kimaernoudt/custom-ahm-wallpanel/3d/render-back.png

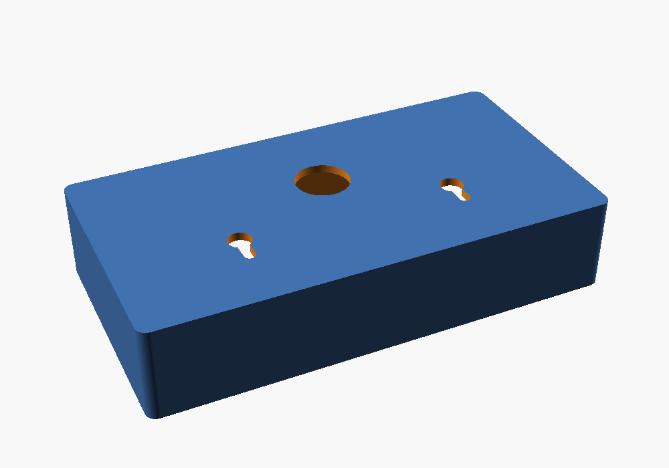
3d/render-back.png
