kimaernoudt/custom-ahm-wallpanel/pcb/parts.csv

ref | value | footprint | lcsc | side
ENC1 | EC11E with switch, 20 mm shaft | RotaryEncoder_Alps_EC11E-Switch_Vertical_H20mm |  | top
ENC2 | EC11E with switch, 20 mm shaft | RotaryEncoder_Alps_EC11E-Switch_Vertical_H20mm |  | top
ENC3 | EC11E with switch, 20 mm shaft | RotaryEncoder_Alps_EC11E-Switch_Vertical_H20mm |  | top
ENC4 | EC11E with switch, 20 mm shaft | RotaryEncoder_Alps_EC11E-Switch_Vertical_H20mm |  | top
LED1 | WS2812B-B | LED_WS2812B_PLCC4_5.0x5.0mm_P3.2mm |  | top
LED2 | WS2812B-B | LED_WS2812B_PLCC4_5.0x5.0mm_P3.2mm |  | top
LED3 | WS2812B-B | LED_WS2812B_PLCC4_5.0x5.0mm_P3.2mm |  | top
LED4 | WS2812B-B | LED_WS2812B_PLCC4_5.0x5.0mm_P3.2mm |  | top
LED5 | WS2812B-B | LED_WS2812B_PLCC4_5.0x5.0mm_P3.2mm |  | top
LED6 | WS2812B-B | LED_WS2812B_PLCC4_5.0x5.0mm_P3.2mm |  | top
LED7 | WS2812B-B | LED_WS2812B_PLCC4_5.0x5.0mm_P3.2mm |  | top
LED8 | WS2812B-B | LED_WS2812B_PLCC4_5.0x5.0mm_P3.2mm |  | top
LED9 | WS2812B-B | LED_WS2812B_PLCC4_5.0x5.0mm_P3.2mm |  | top
LED10 | WS2812B-B | LED_WS2812B_PLCC4_5.0x5.0mm_P3.2mm |  | top
LED11 | WS2812B-B | LED_WS2812B_PLCC4_5.0x5.0mm_P3.2mm |  | top
LED12 | WS2812B-B | LED_WS2812B_PLCC4_5.0x5.0mm_P3.2mm |  | top
LED13 | WS2812B-B | LED_WS2812B_PLCC4_5.0x5.0mm_P3.2mm |  | top
LED14 | WS2812B-B | LED_WS2812B_PLCC4_5.0x5.0mm_P3.2mm |  | top
LED15 | WS2812B-B | LED_WS2812B_PLCC4_5.0x5.0mm_P3.2mm |  | top
LED16 | WS2812B-B | LED_WS2812B_PLCC4_5.0x5.0mm_P3.2mm |  | top
LED17 | WS2812B-B | LED_WS2812B_PLCC4_5.0x5.0mm_P3.2mm |  | top
LED18 | WS2812B-B | LED_WS2812B_PLCC4_5.0x5.0mm_P3.2mm |  | top
LED19 | WS2812B-B | LED_WS2812B_PLCC4_5.0x5.0mm_P3.2mm |  | top
LED20 | WS2812B-B | LED_WS2812B_PLCC4_5.0x5.0mm_P3.2mm |  | top
LED21 | WS2812B-B | LED_WS2812B_PLCC4_5.0x5.0mm_P3.2mm |  | top
LED22 | WS2812B-B | LED_WS2812B_PLCC4_5.0x5.0mm_P3.2mm |  | top
LED23 | WS2812B-B | LED_WS2812B_PLCC4_5.0x5.0mm_P3.2mm |  | top
LED24 | WS2812B-B | LED_WS2812B_PLCC4_5.0x5.0mm_P3.2mm |  | top
LED25 | WS2812B-B | LED_WS2812B_PLCC4_5.0x5.0mm_P3.2mm |  | top
LED26 | WS2812B-B | LED_WS2812B_PLCC4_5.0x5.0mm_P3.2mm |  | top
LED27 | WS2812B-B | LED_WS2812B_PLCC4_5.0x5.0mm_P3.2mm |  | top
LED28 | WS2812B-B | LED_WS2812B_PLCC4_5.0x5.0mm_P3.2mm |  | top
LED29 | WS2812B-B | LED_WS2812B_PLCC4_5.0x5.0mm_P3.2mm |  | top
LED30 | WS2812B-B | LED_WS2812B_PLCC4_5.0x5.0mm_P3.2mm |  | top
LED31 | WS2812B-B | LED_WS2812B_PLCC4_5.0x5.0mm_P3.2mm |  | top
LED32 | WS2812B-B | LED_WS2812B_PLCC4_5.0x5.0mm_P3.2mm |  | top
LED33 | WS2812B-B | LED_WS2812B_PLCC4_5.0x5.0mm_P3.2mm |  | top
LED34 | WS2812B-B | LED_WS2812B_PLCC4_5.0x5.0mm_P3.2mm |  | top
LED35 | WS2812B-B | LED_WS2812B_PLCC4_5.0x5.0mm_P3.2mm |  | top
LED36 | WS2812B-B | LED_WS2812B_PLCC4_5.0x5.0mm_P3.2mm |  | top
LED37 | WS2812B-B | LED_WS2812B_PLCC4_5.0x5.0mm_P3.2mm |  | top
LED38 | WS2812B-B | LED_WS2812B_PLCC4_5.0x5.0mm_P3.2mm |  | top
LED39 | WS2812B-B | LED_WS2812B_PLCC4_5.0x5.0mm_P3.2mm |  | top
LED40 | WS2812B-B | LED_WS2812B_PLCC4_5.0x5.0mm_P3.2mm |  | top
LED41 | WS2812B-B | LED_WS2812B_PLCC4_5.0x5.0mm_P3.2mm |  | top
LED42 | WS2812B-B | LED_WS2812B_PLCC4_5.0x5.0mm_P3.2mm |  | top
LED43 | WS2812B-B | LED_WS2812B_PLCC4_5.0x5.0mm_P3.2mm |  | top
LED44 | WS2812B-B | LED_WS2812B_PLCC4_5.0x5.0mm_P3.2mm |  | top
LED45 | WS2812B-B | LED_WS2812B_PLCC4_5.0x5.0mm_P3.2mm |  | top
LED46 | WS2812B-B | LED_WS2812B_PLCC4_5.0x5.0mm_P3.2mm |  | top
LED47 | WS2812B-B | LED_WS2812B_PLCC4_5.0x5.0mm_P3.2mm |  | top
LED48 | WS2812B-B | LED_WS2812B_PLCC4_5.0x5.0mm_P3.2mm |  | top
LED49 | WS2812B-B | LED_WS2812B_PLCC4_5.0x5.0mm_P3.2mm |  | top
LED50 | WS2812B-B | LED_WS2812B_PLCC4_5.0x5.0mm_P3.2mm |  | top
LED51 | WS2812B-B | LED_WS2812B_PLCC4_5.0x5.0mm_P3.2mm |  | top
LED52 | WS2812B-B | LED_WS2812B_PLCC4_5.0x5.0mm_P3.2mm |  | top
SW1 | 6x6 mm tact, 5 mm high | SW_PUSH_6mm_H5mm |  | top
SW2 | 6x6 mm tact, 5 mm high | SW_PUSH_6mm_H5mm |  | top
R2 | 3.3k | R_0805_2012Metric |  | top
SW3 | 6x6 mm tact, 5 mm high | SW_PUSH_6mm_H5mm |  | top
R3 | 8.2k | R_0805_2012Metric |  | top
SW4 | 6x6 mm tact, 5 mm high | SW_PUSH_6mm_H5mm |  | top
R4 | 22k | R_0805_2012Metric |  | top
C1 | 100nF | C_0805_2012Metric |  | top
U1 | MCP23017-E/SO | SOIC-28W_7.5x17.9mm_P1.27mm | C47023 | top
C2 | 100nF | C_0805_2012Metric |  | top
R5 | 10k | R_0805_2012Metric |  | top
J1 | UEXT 2x5 box header | IDC-Header_2x05_P2.54mm_Vertical |  | bottom
J2 | JST XH 2-pin | JST_XH_B2B-XH-A_1x02_P2.50mm_Vertical |  | bottom
C3 | 22uF | C_1206_3216Metric |  | top
C4 | 22uF | C_1206_3216Metric |  | top
C5 | 10uF | C_0805_2012Metric |  | top
C6 | 10uF | C_0805_2012Metric |  | top
C7 | 10uF | C_0805_2012Metric |  | top
C8 | 10uF | C_0805_2012Metric |  | top
U2 | 74AHCT1G125 | SOT-23-5 | C7484 | top
C9 | 100nF | C_0805_2012Metric |  | top
R8 | 33R | R_0805_2012Metric |  | top
