kimaernoudt/custom-ahm-wallpanel/3d/faceplate-pcb.stl

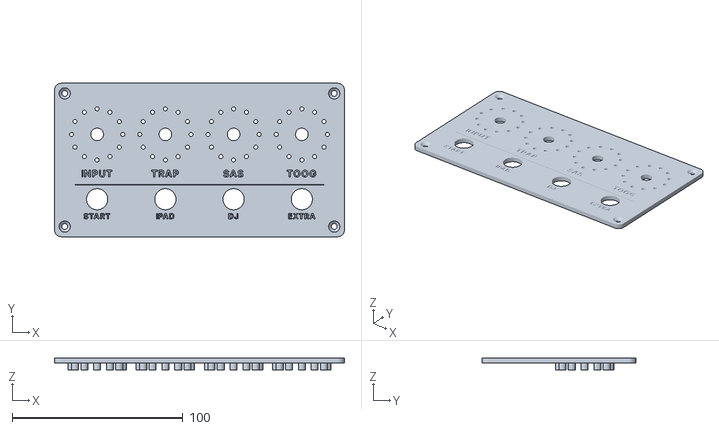
[picture p6: CAD file, 2026-10-20]
3d/faceplate-pcb.stl
170.0 x 90.0 x 7.30
