kimaernoudt/custom-ahm-wallpanel/3d/buttoncap.stl

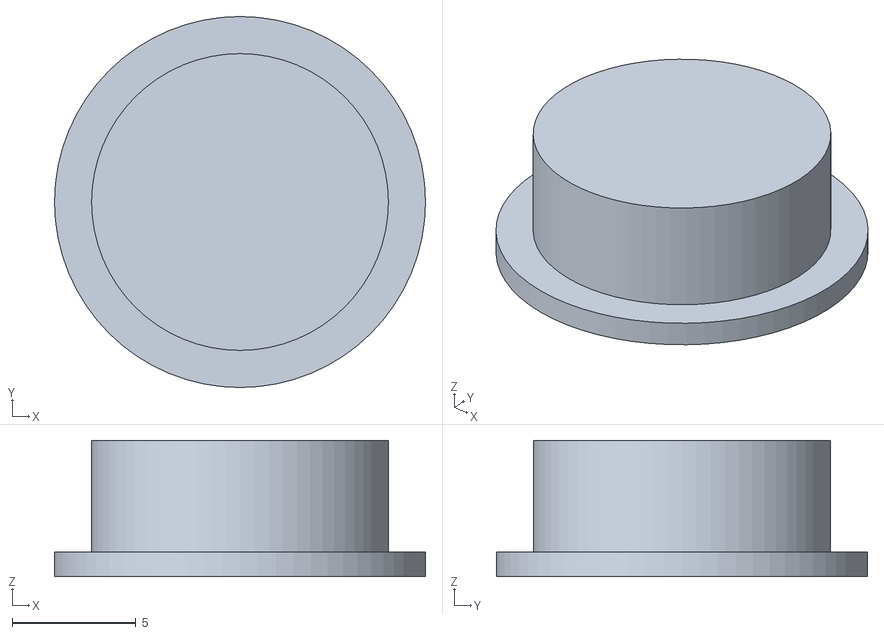
[picture p7: CAD file, 2026-10-20]
3d/buttoncap.stl
15.0 x 15.0 x 5.50
