kimaernoudt/custom-ahm-wallpanel/3d/backbox.stl

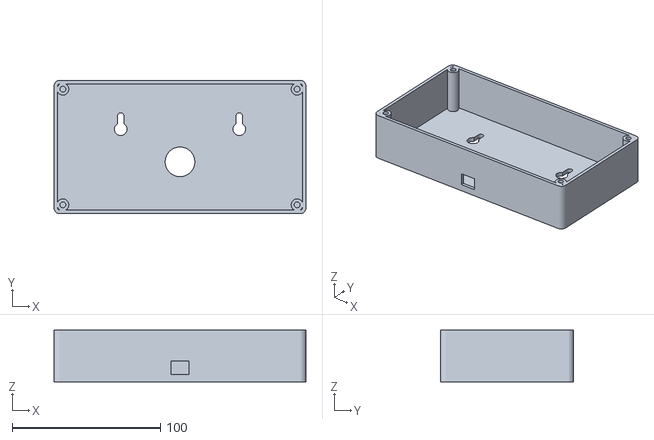
[picture p8: CAD file, 2026-10-19]
3d/backbox.stl
170.0 x 90.0 x 35.0
