kimaernoudt/custom-ahm-wallpanel/3d/faceplate.stl

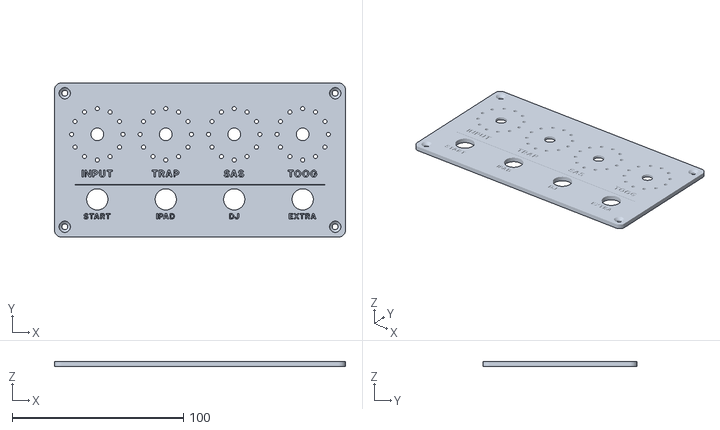
[picture p9: CAD file, 2026-10-19]
3d/faceplate.stl
170.0 x 90.0 x 3.00
