kimaernoudt/custom-ahm-wallpanel/3d/labels.stl

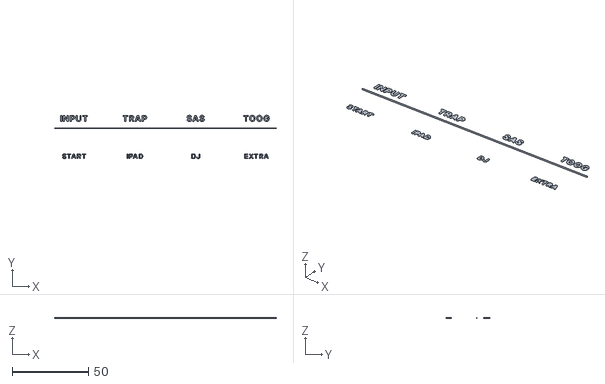
[picture p10: CAD file, 2026-10-19]
3d/labels.stl
146.0 x 28.6 x 0.6
