kimaernoudt/custom-ahm-wallpanel/3d/render-assembly.png

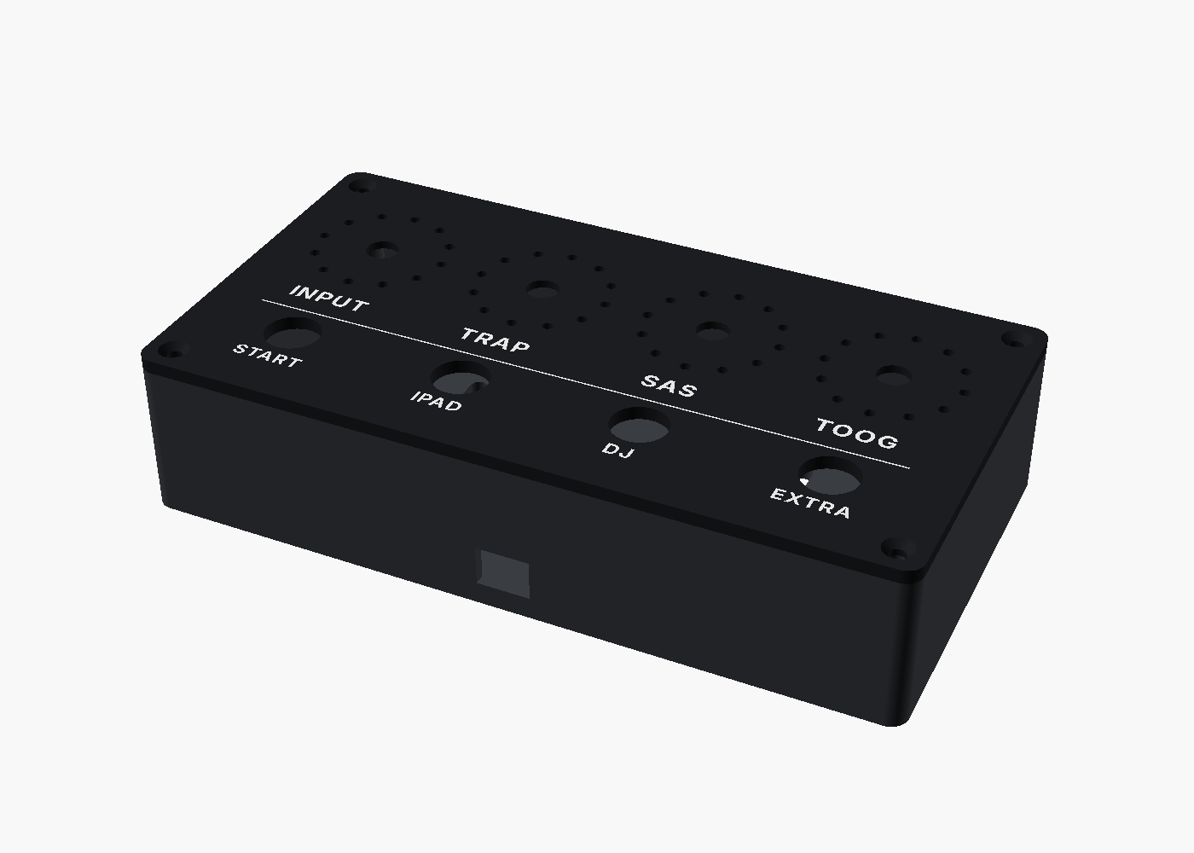
3d/render-assembly.png
