kimaernoudt/custom-ahm-wallpanel/pcb/ahm-panel.kicad_pcb

## KiCad design pcb/ahm-panel.kicad_pcb (2026-10-21)

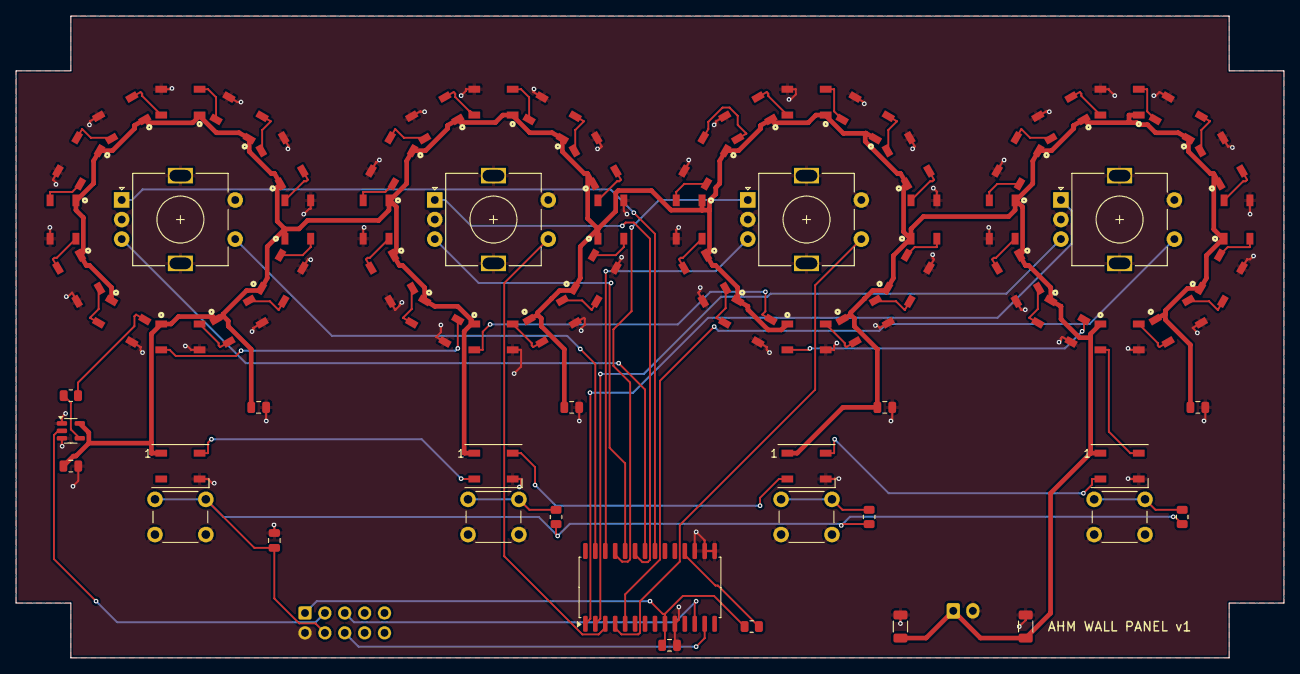
[picture p12: board ahm-panel.kicad_pcb from above]

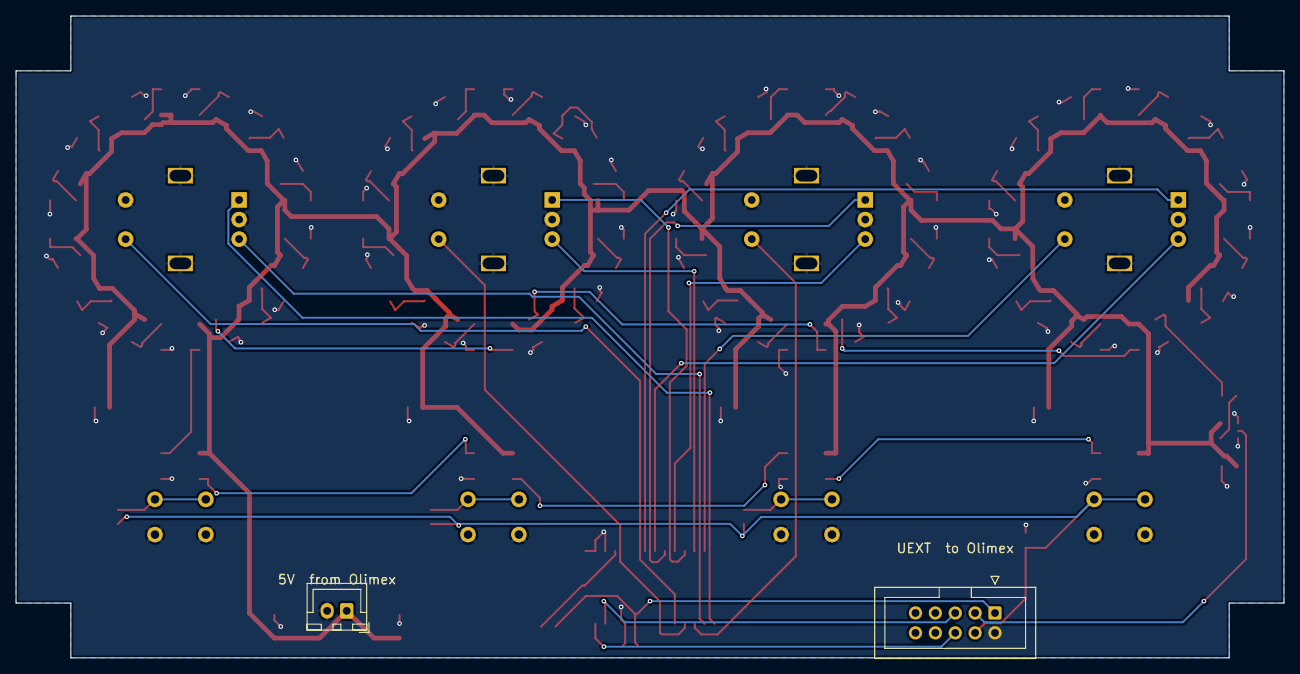
[picture p13: board ahm-panel.kicad_pcb from below]

Board: 2 copper layers, 162.0 x 82.0 mm, 78 parts (2 on the bottom side), 76 nets.

Parts:
C1, C2, C9: 100nF; C_0805_2012Metric
C3, C4: 22uF; C_1206_3216Metric
C5, C6, C7, C8: 10uF; C_0805_2012Metric
ENC1, ENC2, ENC3, ENC4: EC11E with switch, 20 mm shaft; RotaryEncoder_Alps_EC11E-Switch_Vertical_H20mm
J1: UEXT 2x5 box header; IDC-Header_2x05_P2.54mm_Vertical
J2: JST XH 2-pin; JST_XH_B2B-XH-A_1x02_P2.50mm_Vertical
LED1, LED2, LED3, LED4, LED5, LED6, LED7, LED8, LED9, LED10, LED11, LED12, LED13, LED14, LED15, LED16, LED17, LED18, LED19, LED20, LED21, LED22, LED23, LED24, LED25, LED26, LED27, LED28, LED29, LED30, LED31, LED32, LED33, LED34, LED35, LED36, LED37, LED38, LED39, LED40, LED41, LED42, LED43, LED44, LED45, LED46, LED47, LED48, LED49, LED50, LED51, LED52: WS2812B-B; LED_WS2812B_PLCC4_5.0x5.0mm_P3.2mm
R2: 3.3k; R_0805_2012Metric
R3: 8.2k; R_0805_2012Metric
R4: 22k; R_0805_2012Metric
R5: 10k; R_0805_2012Metric
R8: 33R; R_0805_2012Metric
SW1, SW2, SW3, SW4: 6x6 mm tact, 5 mm high; SW_PUSH_6mm_H5mm
U1: MCP23017-E/SO; SOIC-28W_7.5x17.9mm_P1.27mm
U2: 74AHCT1G125; SOT-23-5

Connections:
+3V3: C2.1, J1.1, R5.1, U1.9
+5V: C3.1, C4.1, C5.1, C6.1, C7.1, C8.1, C9.1, J2.1, LED1.1, LED2.1, LED3.1, LED4.1, LED5.1, LED6.1, LED7.1, LED8.1, LED9.1, LED10.1, LED11.1, LED12.1, LED13.1, LED14.1, LED15.1, LED16.1, LED17.1, LED18.1, LED19.1, LED20.1, LED21.1, LED22.1, LED23.1, LED24.1, LED25.1, LED26.1, LED27.1, LED28.1, LED29.1, LED30.1, LED31.1, LED32.1, LED33.1, LED34.1, LED35.1, LED36.1, LED37.1, LED38.1, LED39.1, LED40.1, LED41.1, LED42.1, LED43.1, LED44.1, LED45.1, LED46.1, LED47.1, LED48.1, LED49.1, LED50.1, LED51.1, LED52.1, U2.5
D1: LED1.2, LED2.4
D2: LED2.2, LED3.4
D3: LED3.2, LED4.4
D4: LED4.2, LED5.4
D5: LED5.2, LED6.4
D6: LED6.2, LED7.4
D7: LED7.2, LED8.4
D8: LED8.2, LED9.4
D9: LED9.2, LED10.4
D10: LED10.2, LED11.4
D11: LED11.2, LED12.4
D12: LED12.2, LED13.4
D13: LED13.2, LED14.4
D14: LED14.2, LED15.4
D15: LED15.2, LED16.4
D16: LED16.2, LED17.4
D17: LED17.2, LED18.4
D18: LED18.2, LED19.4
D19: LED19.2, LED20.4
D20: LED20.2, LED21.4
D21: LED21.2, LED22.4
D22: LED22.2, LED23.4
D23: LED23.2, LED24.4
D24: LED24.2, LED25.4
D25: LED25.2, LED26.4
D26: LED26.2, LED27.4
D27: LED27.2, LED28.4
D28: LED28.2, LED29.4
D29: LED29.2, LED30.4
D30: LED30.2, LED31.4
D31: LED31.2, LED32.4
D32: LED32.2, LED33.4
D33: LED33.2, LED34.4
D34: LED34.2, LED35.4
D35: LED35.2, LED36.4
D36: LED36.2, LED37.4
D37: LED37.2, LED38.4
D38: LED38.2, LED39.4
D39: LED39.2, LED40.4
D40: LED40.2, LED41.4
D41: LED41.2, LED42.4
D42: LED42.2, LED43.4
D43: LED43.2, LED44.4
D44: LED44.2, LED45.4
D45: LED45.2, LED46.4
D46: LED46.2, LED47.4
D47: LED47.2, LED48.4
D48: LED48.2, LED49.4
D49: LED49.2, LED50.4
D50: LED50.2, LED51.4
D51: LED51.2, LED52.4
ENC1_A: ENC1.A, U1.21
ENC1_B: ENC1.B, U1.22
ENC1_SW: ENC1.S1, U1.27
ENC2_A: ENC2.A, U1.23
ENC2_B: ENC2.B, U1.24
ENC2_SW: ENC2.S1, U1.3
ENC3_A: ENC3.A, U1.25
ENC3_B: ENC3.B, U1.26
ENC3_SW: ENC3.S1, U1.4
ENC4_A: ENC4.A, U1.1
ENC4_B: ENC4.B, U1.2
ENC4_SW: ENC4.S1, U1.5
GND: C1.2, C2.2, C3.2, C4.2, C5.2, C6.2, C7.2, C8.2, C9.2, ENC1.C, ENC1.MP, ENC1.S2, ENC2.C, ENC2.MP, ENC2.S2, ENC3.C, ENC3.MP, ENC3.S2, ENC4.C, ENC4.MP, ENC4.S2, J1.2, J2.2, LED1.3, LED2.3, LED3.3, LED4.3, LED5.3, LED6.3, LED7.3, LED8.3, LED9.3, LED10.3, LED11.3, LED12.3, LED13.3, LED14.3, LED15.3, LED16.3, LED17.3, LED18.3, LED19.3, LED20.3, LED21.3, LED22.3, LED23.3, LED24.3, LED25.3, LED26.3, LED27.3, LED28.3, LED29.3, LED30.3, LED31.3, LED32.3, LED33.3, LED34.3, LED35.3, LED36.3, LED37.3, LED38.3, LED39.3, LED40.3, LED41.3, LED42.3, LED43.3, LED44.3, LED45.3, LED46.3, LED47.3, LED48.3, LED49.3, LED50.3, LED51.3, LED52.3, SW1.2, SW2.2, SW3.2, SW4.2, U1.10, U1.15, U1.16, U1.17, U2.1, U2.3
LAD2: R2.2, SW2.1
LAD3: R3.2, SW3.1
LAD4: R4.2, SW4.1
LADDER: C1.1, J1.4, R2.1, R3.1, R4.1, SW1.1
LED_3V3: J1.3, U2.2
LED_5V: R8.1, U2.4
LED_DATA: LED1.4, R8.2
RST: R5.2, U1.18
SCL: J1.5, U1.12
SDA: J1.6, U1.13
