kimaernoudt/custom-ahm-wallpanel/(commit log)

2026-10-19 Initial wall panel design: faceplate, 3D enclosure, wiring, parts list, AHM test sketch
    Claude-Session: https://claude.ai/code/session_01VPESywWKp5d8Boox5CGCGB
    [ahm-panel.scad, backbox.stl, faceplate.stl, labels.stl]
2026-10-20 Add Pro Micro encoder test and USB-to-AHM bridge
    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
2026-10-20 Add panel PCB (KiCad 7) with production files
    Encoders, scene buttons, 52 WS2812 LEDs and the MCP23017 on one 162x82 mm board
    that hangs from the encoder nuts; UEXT cable to the Olimex. Firmware gets a
    PANEL_PCB build option, the faceplate a PCB variant with light tubes and caps.
    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
    [ahm-panel-B_Cu.gbl, ahm-panel-B_Mask.gbs, ahm-panel-B_Paste.gbp, ahm-panel-B_Silkscreen.gbo, ahm-panel-Edge_Cuts.gm1, ahm-panel-F_Cu.gtl, ahm-panel-F_Mask.gts, ahm-panel-F_Paste.gtp]
2026-10-20 Placement file with JLCPCB column names
    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
    [ahm-panel-cpl-jlc.csv]
2026-10-20 JLCPCB BOM: only the parts JLC fits; hand-solder list separate
    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
    [ahm-panel-bom.csv, hand-solder.csv]
2026-10-20 PCB: button LEDs now 5050 WS2812B, re-routed
    The WS2812B-2020 footprint was wired with the 5050 pin order (wrong for the
    2020 part), and JLCPCB had almost none in stock. All 52 LEDs are now the same
    5050 part. Adds export.sh for the production files.
    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
    [ahm-panel-B_Cu.gbl, ahm-panel-B_Mask.gbs, ahm-panel-B_Paste.gbp, ahm-panel-B_Silkscreen.gbo, ahm-panel-Edge_Cuts.gm1, ahm-panel-F_Cu.gtl, ahm-panel-F_Mask.gts, ahm-panel-F_Paste.gtp]
2026-10-20 Knob presses no longer mute
    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
    [ahm_panel.ino]
2026-10-21 BOM: WS2812B-B/W C114586 (in stock at JLCPCB)
    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
    [ahm-panel-bom.csv, ahm-panel-placed.kicad_pcb, parts.csv]
2026-10-21 PCB: pin-1 dots on the ring LEDs for hand soldering
    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
    [ahm-panel-B_Cu.gbl, ahm-panel-B_Mask.gbs, ahm-panel-B_Paste.gbp, ahm-panel-B_Silkscreen.gbo, ahm-panel-Edge_Cuts.gm1, ahm-panel-F_Cu.gtl, ahm-panel-F_Mask.gts, ahm-panel-F_Paste.gtp]
2026-10-21 BOM: LEDs hand-soldered (none in JLCPCB assembly library)
    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
    [ahm-panel-B_Cu.gbl, ahm-panel-B_Mask.gbs, ahm-panel-B_Paste.gbp, ahm-panel-B_Silkscreen.gbo, ahm-panel-Edge_Cuts.gm1, ahm-panel-F_Cu.gtl, ahm-panel-F_Mask.gts, ahm-panel-F_Paste.gtp]
2026-10-21 PCB review fixes: scene ladder for the Olimex diode, decoupling, power cap
    - The Olimex feeds UEXT pin 4 to GPIO36 through a Schottky diode with its own
    10k pull-up (Rev L schematic). With the board's own pull-up the ladder read
    about 0.4 V too high and DJ/IPAD would be confused. Dropped R1, ladder is now
    0/3.3k/8.2k/22k with PCB-specific thresholds in the firmware.
    - Dropped the 4.7k I2C pull-ups (the Olimex has 2.2k).
    - MCP23017 decoupling cap moved under VDD/VSS (was 16 mm away); re-routed.
    - LED brightness capped at 160 to stay well inside the Olimex 5 V / 2 A rail.
    Claude-Session: https://claude.ai/code/session_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
    [ahm-panel-B_Cu.gbl, ahm-panel-B_Mask.gbs, ahm-panel-B_Paste.gbp, ahm-panel-B_Silkscreen.gbo, ahm-panel-Edge_Cuts.gm1, ahm-panel-F_Cu.gtl, ahm-panel-F_Mask.gts, ahm-panel-F_Paste.gtp]
2026-11-04 ahm_test: NetworkClient for esp32 core 3.x (WiFiClient no longer comes with ETH.h)
    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
    [ahm_test.ino]
